Ildaron/ironbci/README.md

# Brain-Computer Interface ironbci (soon will be available in the market)

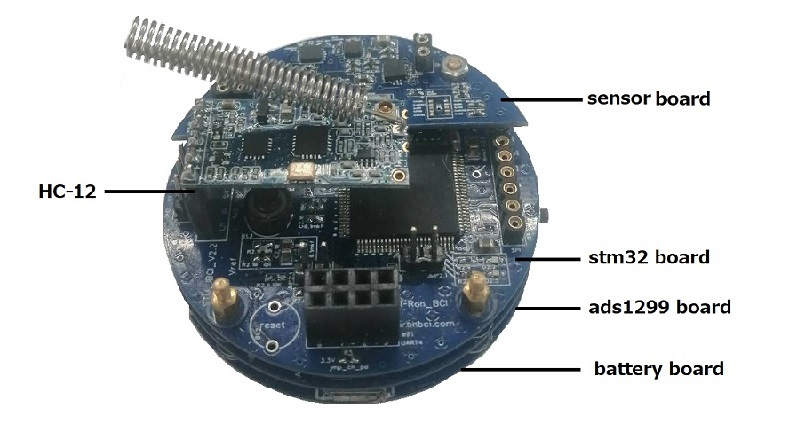
[picture p1: Supplementary files/general_view.jpg]
general view


####  ADS1299 and STM32F407VE 
-  [How it Works](https://github.com/Ildaron/ironbci/blob/master/README.md#1-how-it-works)  
-  [Device pinout](https://github.com/Ildaron/ironbci#2--general-pin-information-about-ads1299-signals)   
-  [Configuration of control registers](https://github.com/Ildaron/ironbci#3-configuration-of-control-registers)     
-  [Description of code ADS_1299.c](https://github.com/Ildaron/ironbci#4-description-of-code-ads_1299c)    
-  [STM32 programming](https://github.com/Ildaron/ironbci#5-stm32-programming)  
-  [Hardware and Signal processing demonstrations](https://github.com/Ildaron/ironbci#6-hardware-and-signal-processing-demonstrations)     
-  [Citation](https://github.com/Ildaron/ironbci/blob/master/README.md#7-citation)   
-  [Contacts](https://github.com/Ildaron/ironbci/blob/master/README.md#8-contacts)     

[GNU license](https://github.com/Ildaron/ironbci/blob/master/license.txt)
#### How it Works  
[Gerbers files](https://github.com/Ildaron/ironbci/tree/master/gerber_files) for PCB boards.  
[Hex file](https://github.com/Ildaron/ironbci/blob/master/ironbci.hex) can be uploaded to STM32F407VE by ST-LINK V2 RST  
   
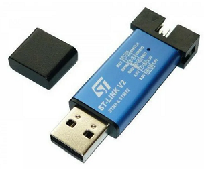
[picture p2: Supplementary files/stl1.bmp]


####  2.  General pin information about ADS1299 signals
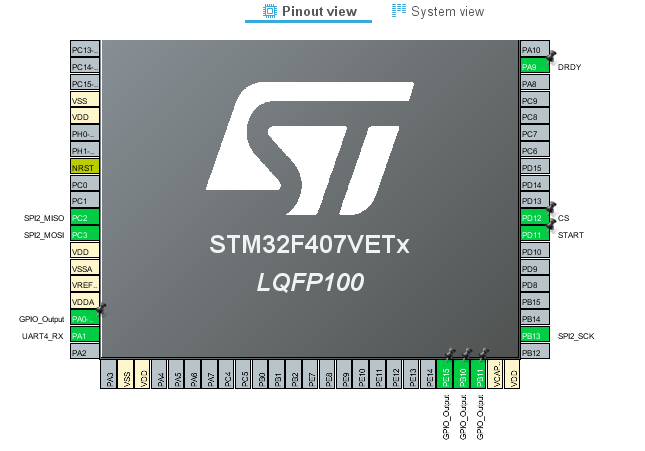
[picture p3: Supplementary files/stm1.bmp]
  
SPI2 for communicate with ADS1299    
UAART4 for send data by HC-12  
2.1.DRDY output -  high when conversion starts    
2.2  Two ways to read data:      
      - RDATA - continuous read command;      
      - SDATA - on request.  
2.3. The amount of input data - 24 * 8 = 192 bits + 24 status bits, a total - 216 bits  

#### 3. Configuration of control registers  

#### 4. Description of code ADS_1299.c  
Data transfer - "s", ends - "p"  
Serial with baud rate - 115200.
 
Hardware demonstrations  
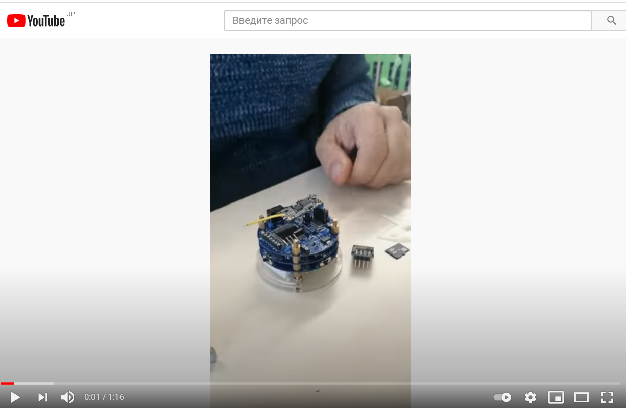
[picture p4: Supplementary files/hardware_ironbci.bmp]
Hardware demonstrations (https://youtu.be/kfbvYXvBCJk)
    
Signal processing by brainflov via timeflux (https://timeflux.io/)    
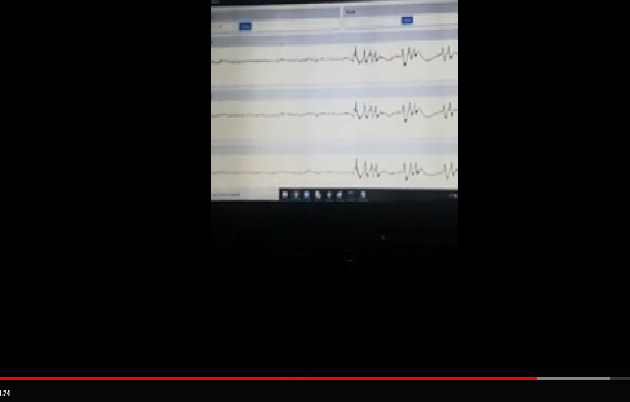
[picture p5: Supplementary files/software.bmp]
Software demonstrations (https://youtu.be/y1O7FNJLeh4)
      

#### 6. Citation  
Rakhmatulin, I., Parfenov, A., Traylor, Z. et al. Low-cost brain computer interface for everyday use. Exp Brain Res (2021). https://doi.org/10.1007/s00221-021-06231-4

#### 7. Contacts   
https://pieeg.com/
