Ildaron/ironbci/SDL/readme.txt

If 120 bytes are currently received, i.e. 40 samples per channel, then now it's the same 120 bytes, but 10 samples per channel. That is, the protocol is 3 bytes, first channel, 3 bytes second channel, 3 bytes third channel, 3 bytes 4th channel and again
