Ildaron/ironbci/Supplementary files/gerber_DIY.bmp

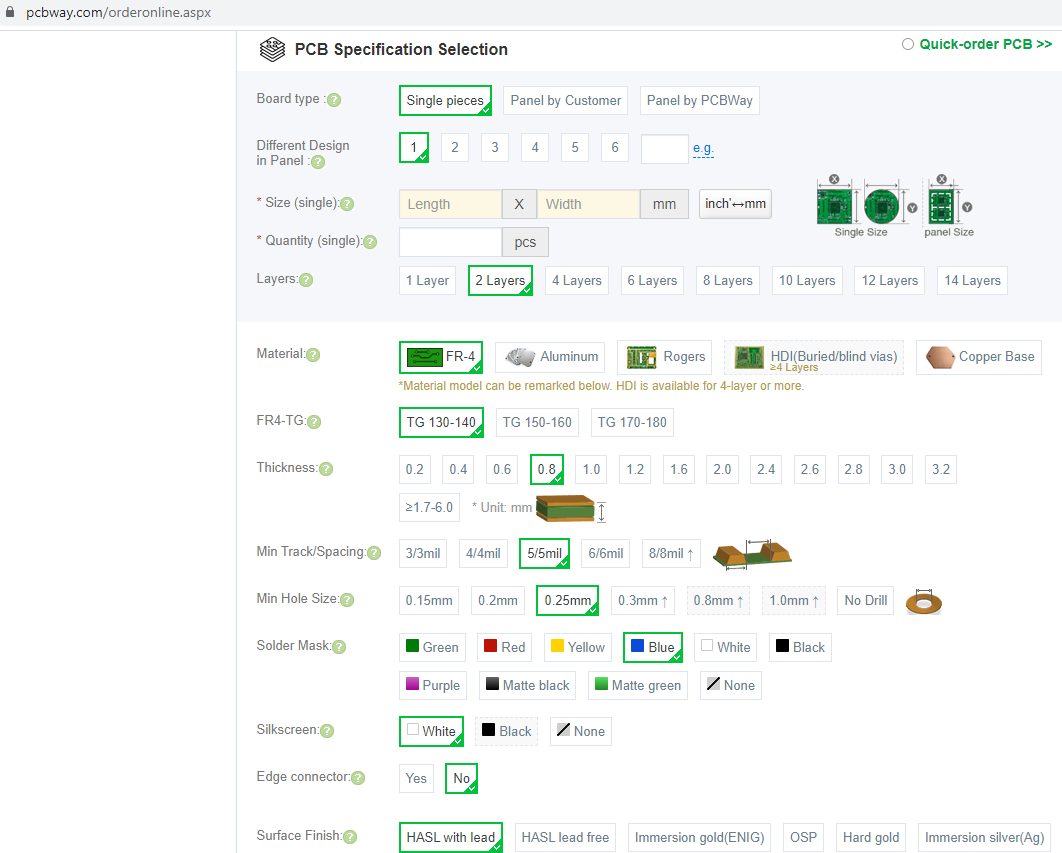
Supplementary files/gerber_DIY.bmp
