Ildaron/ironbci/Supplementary files/pcbway.bmp

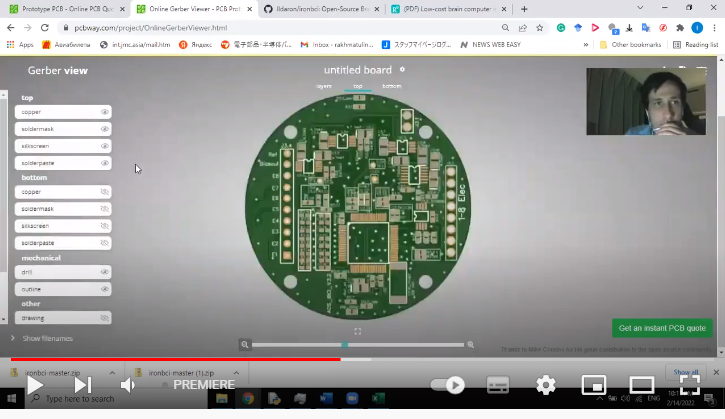
Supplementary files/pcbway.bmp
