Ildaron/ironbci/BOM_files/1.BOM_POWER SUPPLY1.xlsx

 |  |  |  |  |  |  | xxxx xxxx xxxxx xxPCS BOM
3sets unit price |  |  | Your comments | Item # | *Designator | *Qty | Manufacturer | *Mfg Part # | Description / Value | *Package/Footprint | Type | Your Instructions / Notes
$0.105 | $0.315 | Provide 1/16W, no 1/8W, please confirm. | confirm. | 1 | R1.2 | 1 |  |  | RES 110K OHM 1/8W (also acceptable 1/16W) 1% 0402 SMD | 0402 | SMD
$0.105 | $0.315 | Provide 1/16W, no 1/8W, please confirm. | confirm. | 2 | R1.1 | 1 |  |  | RES 15K OHM 1/8W (also acceptable 1/16W) 1% 0402 SMD | 0402 | SMD
$0.105 | $0.315 | Provide 1/16W, no 1/8W, please confirm. | confirm. | 3 | R1.3 | 1 |  |  | RES 1.2K OHM 1/8W (also acceptable 1/16W) 1% 0402 SMD | 0402 | SMD
$0.105 | $0.315 | Provide 1/16W, no 1/8W, please confirm. | confirm. | 4 | R.1.4 | 1 |  |  | RES 0.4 OHM 1/8W (also acceptable 1/16W) 1% 0402 SMD | 0402 | SMD
$0.105 | $0.315 | Provide 1/16W, no 1/8W, please confirm. | confirm. | 5 | R.1.5 | 1 |  |  | RES 1 K OHM 1/8W (also acceptable 1/16W) 1% 0402 SMD | 0402 | SMD
$0.105 | $0.315 | Provide 1/16W, no 1/8W, please confirm. | confirm. | 6 | R.1.6 | 1 |  |  | RES 1 K OHM 1/8W (also acceptable 1/16W) 1% 0402 SMD | 0402 | SMD
$0.105 | $0.315 | Provide 1/16W, no 1/8W, please confirm. | confirm. | 7 | R1.7 | 1 |  |  | RES 1 K OHM 1/8W (also acceptable 1/16W) 1% 0402 SMD | 0402 | SMD
$0.105 | $0.315 | Provide 1/16W, no 1/8W, please confirm. | confirm. | 8 | R1.8 | 1 |  |  | RES 1 K OHM 1/8W (also acceptable 1/16W) 1% 0402 SMD | 0402 | SMD
$0.105 | $0.315 | Provide 1/16W, no 1/8W, please confirm. | confirm. | 9 | R1.9 | 1 |  |  | RES 10 K OHM 1/8W (also acceptable 1/16W) 1% 0402 SMD | 0402 | SMD
$0.525 | $1.575 |  |  | 10 | C1.1 | 1 |  |  | CAP CER 22UF 16V X7R (C0G)1206 | 1206 | SMD
$0.525 | $1.575 |  |  | 11 | C1.2 | 1 |  |  | CAP CER 22UF 16V X7R (C0G)1206 | 1206 | SMD
$0.315 | $0.945 |  |  | 12 | C1.3 | 1 |  |  | CAP CER10UF 16V X7R (C0G)0805 | 805 | SMD
$0.315 | $0.945 |  |  | 13 | C1.4 | 1 |  |  | CAP CER10UF 16V X7R (C0G0805 | 805 | SMD
 | $0.000 | No stock, could you provide the alternative part number? Or can you supply this part to us? | please use - MT3608 | 14 | U1.1 | 1 |  |  | MT3506 |  | SMD
$0.525 | $1.575 |  |  | 15 | U1.2 | 1 |  |  | TC4056A |  | SMD
$0.315 | $0.945 |  |  | 16 | B1.1 | 1 |  |  | MSK-12D19 G2 SPDT 1P2T SMD 3 Pin PCB Panel Horizontal Slide Switch 40JA |  |  | https://www.aliexpress.com/item/4001105071189.html
$0.315 | $0.945 |  |  | 17 | B1.2 | 1 |  |  | MSK-12D19 G2 SPDT 1P2T SMD 3 Pin PCB Panel Horizontal Slide Switch 40JA |  |  | https://www.aliexpress.com/item/4001105071189.html
$0.525 | $1.575 | CDRH104R 22UH |  | 18 | L1.1 | 1 |  |  | 22UH YYT |  | SMD | https://aliexpress.ru/item/4000166903215.html
$0.420 | $1.260 |  |  | 19 | D1.1 | 1 |  |  | SS34 |  | SMD | https://aliexpress.ru/item/1005002002410774.html?s=p&ad_pvid=202108050115474761269999888800003366539_2
$0.210 | $0.630 | Made in China LED 0402 orange |  | 20 | D1.2 | 1 |  |  | LED, ORANGE, lower 20 mA, 3V | 0402 | SMD
$0.210 | $0.630 | Made in China LED 0402 blue |  | 21 | D1.3 | 1 |  |  | LED, BLUE, lower 20 mA, 3V | 0402 | SMD
$0.210 | $0.630 | Made in China LED 0402 green |  | 22 | D1.4 | 1 |  |  | LED, GREEN, lower 20 mA, 3V | 0402 | SMD
$0.263 | $0.788 | Female pin header 1*2pin 2.54mm height:8.5mm Please confirm. | Can you check my order, Order ID: G720488. for elemets - J2.1 was used same of pin | 23 | J.1.1 | 1 |  |  | Round hole pin header 2.54mm pitch row female GOLD single row 2 pins |  |  | https://www.aliexpress.com/item/4001122376295.html?spm=a2g0s.9042311.0.0.27424c4dCdPDpj
$0.525 | $1.575 | According to the link to provide made in China USB | confirm | 24 | J1.2 | 1 |  |  | micro-USB type B |  |  | https://www.aliexpress.com/item/10000001458187.html?s=p&ad_pvid=202108050128122285519604986400008945400_1
$0.210 | $0.630 | XH2.54MM 2P male 180 degrees to the vertical | please see the photo | 25 | J1.3 | 1 |  |  | XH2.54 2 pins bottom side |  |  | https://aliexpress.ru/item/32870387217.html
Total | $19.058
 |  |  |  |  |  |  |  |  | J1.2
According to Description / Value
