Ildaron/ironbci/BOM_files/2.BOM_stm32.xlsx

 |  |  | xxxx xxxx xxxxx xxPCS BOM
Item # | *Designator | *Qty | Manufacturer | *Mfg Part # | Description / Value | *Package/Footprint | Type | Your Instructions / Notes
1 | R2.1 | 1 |  |  | RES 10K OHM 1/8W (also acceptable 1/16W) 1% 0402 SMD | 0402 | SMD
2 | R2.2 | 1 |  |  | RES 10K OHM 1/8W 1% 0402 SMD | 0402 | SMD
3 | R2.3 | 1 |  |  | RES 0K OHM 1/8W 1% 0402 SMD | 0402 | SMD
4 | R2.4 | 1 |  |  | RES 10K OHM 1/8W 1% 0402 SMD | 0402 | SMD
5 | R2.7 | 1 |  |  | RES 10K OHM 1/16W 1% 0402 SMD | 0402 | SMD
6 | R2.12 | 1 |  |  | RES 10K OHM 1/16W 1% 0402 SMD | 0402 | SMD
7 | R2.13 | 1 |  |  | RES 1M OHM 1/16W 1% 0402 SMD | 0402 | SMD
8 | C2.1 | 1 |  |  | CAP CER 10UF 16V X7R (C0G) 0805 | 0805 | SMD
9 | C2.2 | 1 |  |  | CAP CER 0.1UF 16V X7R 0402 | 0402 | SMD
10 | C2.3 | 1 |  |  | CAP CER 10UF 16V X7R 0805 | 0805 | SMD
11 | C2.4 | 1 |  |  | CAP CER 0.1UF 16V X7R 0402 | 0402 | SMD
12 | C2.5 | 1 |  |  | CAP CER 4.7UF 16V X7R (C0G) 0805 | 0805 | SMD
13 | C2.6 | 1 |  |  | CAP CER 10UF 16V X7R (C0G) 0805 | 0805 | SMD
14 | C2.7 | 1 |  |  | CAP CER 10UF 16V X7R (C0G) 0805 | 0805 | SMD
15 | C2.9 | 1 |  |  | CAP CER 0.1UF 16V X7R 0402 | 0402 | SMD
16 | C2.10 | 1 |  |  | CAP CER 10UF 16V X7R (C0G) 0805 | 0805 | SMD
17 | C2.16 | 1 |  |  | CAP CER 0.1UF 16V X7R 0402 | 0402 | SMD
18 | J2.1 | 1 |  |  | Round hole pin header 2.54mm pitch row female GOLD single row 2 pins | N/A | N/A | https://www.aliexpress.com/item/4001122376295.html?spm=a2g0s.9042311.0.0.27424c4dCdPDpj
19 | J2.2 | 1 |  |  | 2.54 40 Pin 1x4 Single Row Male Breakable Pin Header Connector Strip & Jumper Blocks, Black. 4 pins | N/A | N/A | https://www.aliexpress.com/item/32873263301.html?scm_id=1007.34525.229799.0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
20 | J2.3 | 1 |  |  | Round hole pin header 2.54mm pitch row female GOLD single row 7 pins | N/A | N/A | https://www.aliexpress.com/item/4001122376295.html?spm=a2g0s.9042311.0.0.27424c4dCdPDpj
21 | J2.5 | 1 |  |  | 2.54mm Pitch Single Row Female Header Connector Strip Pinheader 5 Pin For Arduino | N/A | N/A | https://www.aliexpress.com/item/1005001418544370.html?scm_id=1007.33416.213724.0&scm-url=1007.33416.213724.0
22 | J2.6 | 1 |  |  | 2.54 40 Pin 1x3 Single Row Male Breakable Pin Header Connector Strip & Jumper Blocks, Black, 3 pins 2.54m | N/A | N/A | https://www.aliexpress.com/item/32873263301.html?scm_id=1007.34525.229799.0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
23 | D2.1 | 1 |  |  | LED, GREEN, lower 20 mA, 3V | 0402 | SMD
24 | D2.2 | 1 |  |  | LED, GREEN, lower 20 mA, 3V | 0402 | SMD
25 | U2.1 | 1 | STMicroelectronics |  | STM32F407VET6 |  | QFP-100/16x16x0.5
26 | U2.1_V3.3 | 1 | AMS1117-3.3V |  |  |  | SMD
