Ildaron/ironbci/electrical_scheme/Board battery.pdf

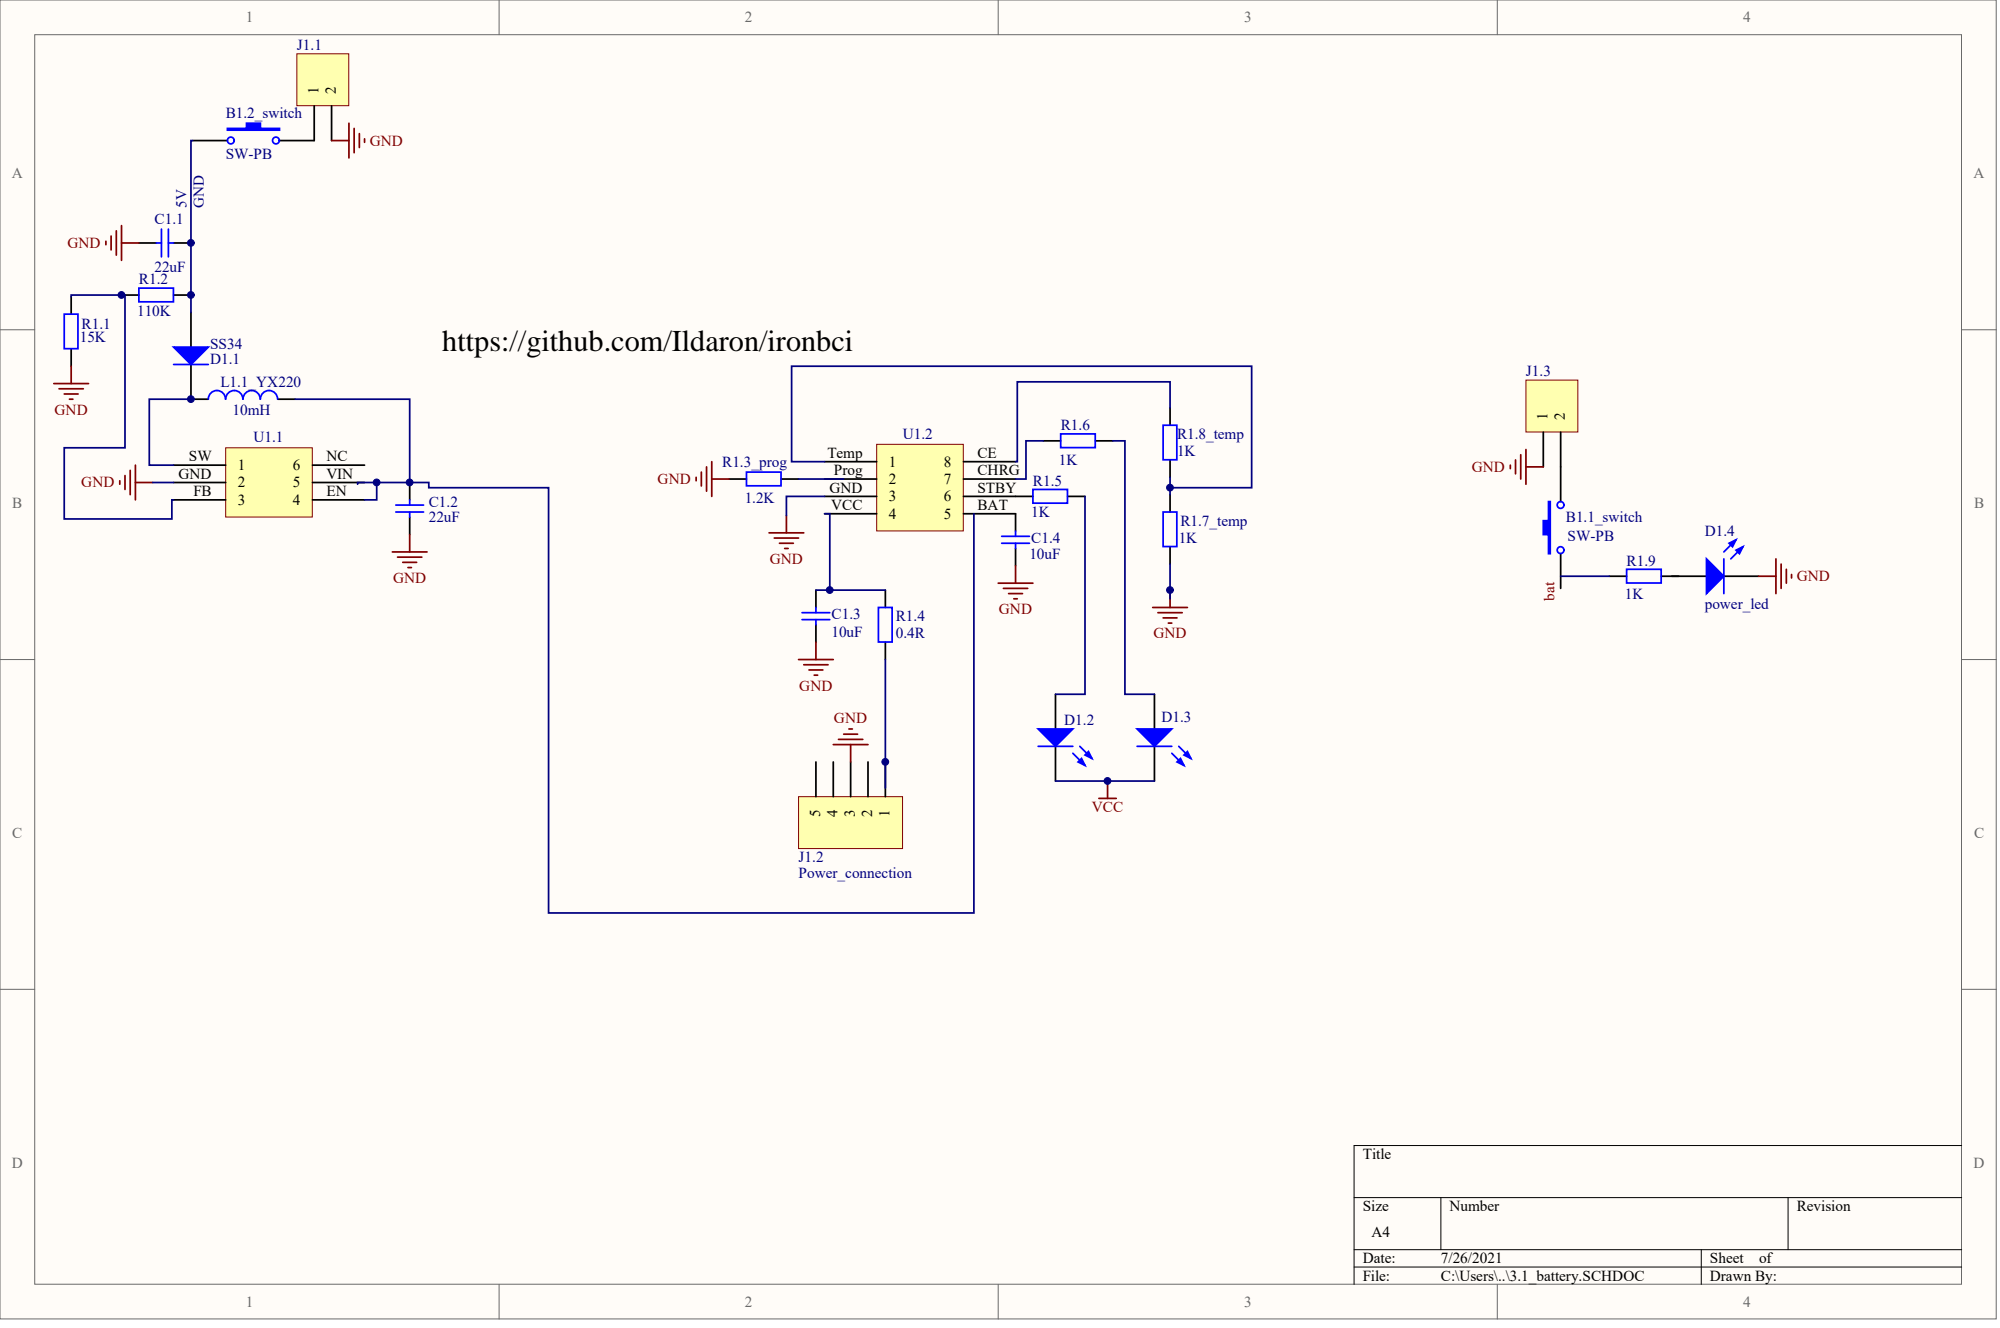
[picture p8: page 1]
Date:; Sheet of File:; C:\Users\..\3.1_battery.SCHDOC; Drawn By; 2 GND; VIN 4; 1 Temp; 2 Prog; 3 GND; 4 VCC; CHRG 6; STBY 5; BAT; J1.2 Power_connection; power_led 1K; P0B1010switch01 P0B1010switch02; P0R1030prog02 P0R1030prog01; P0R1070temp01 P0R1070temp02 P0R1080temp01 P0R1080temp02; P0B1010switch01 P0B1010switch02 P0J10302; P0B1020switch02 P0J10101; P0R1070temp02 P0R1080temp01 P0R1080temp02
