Ildaron/ironbci/electrical_scheme/Board STM32.pdf

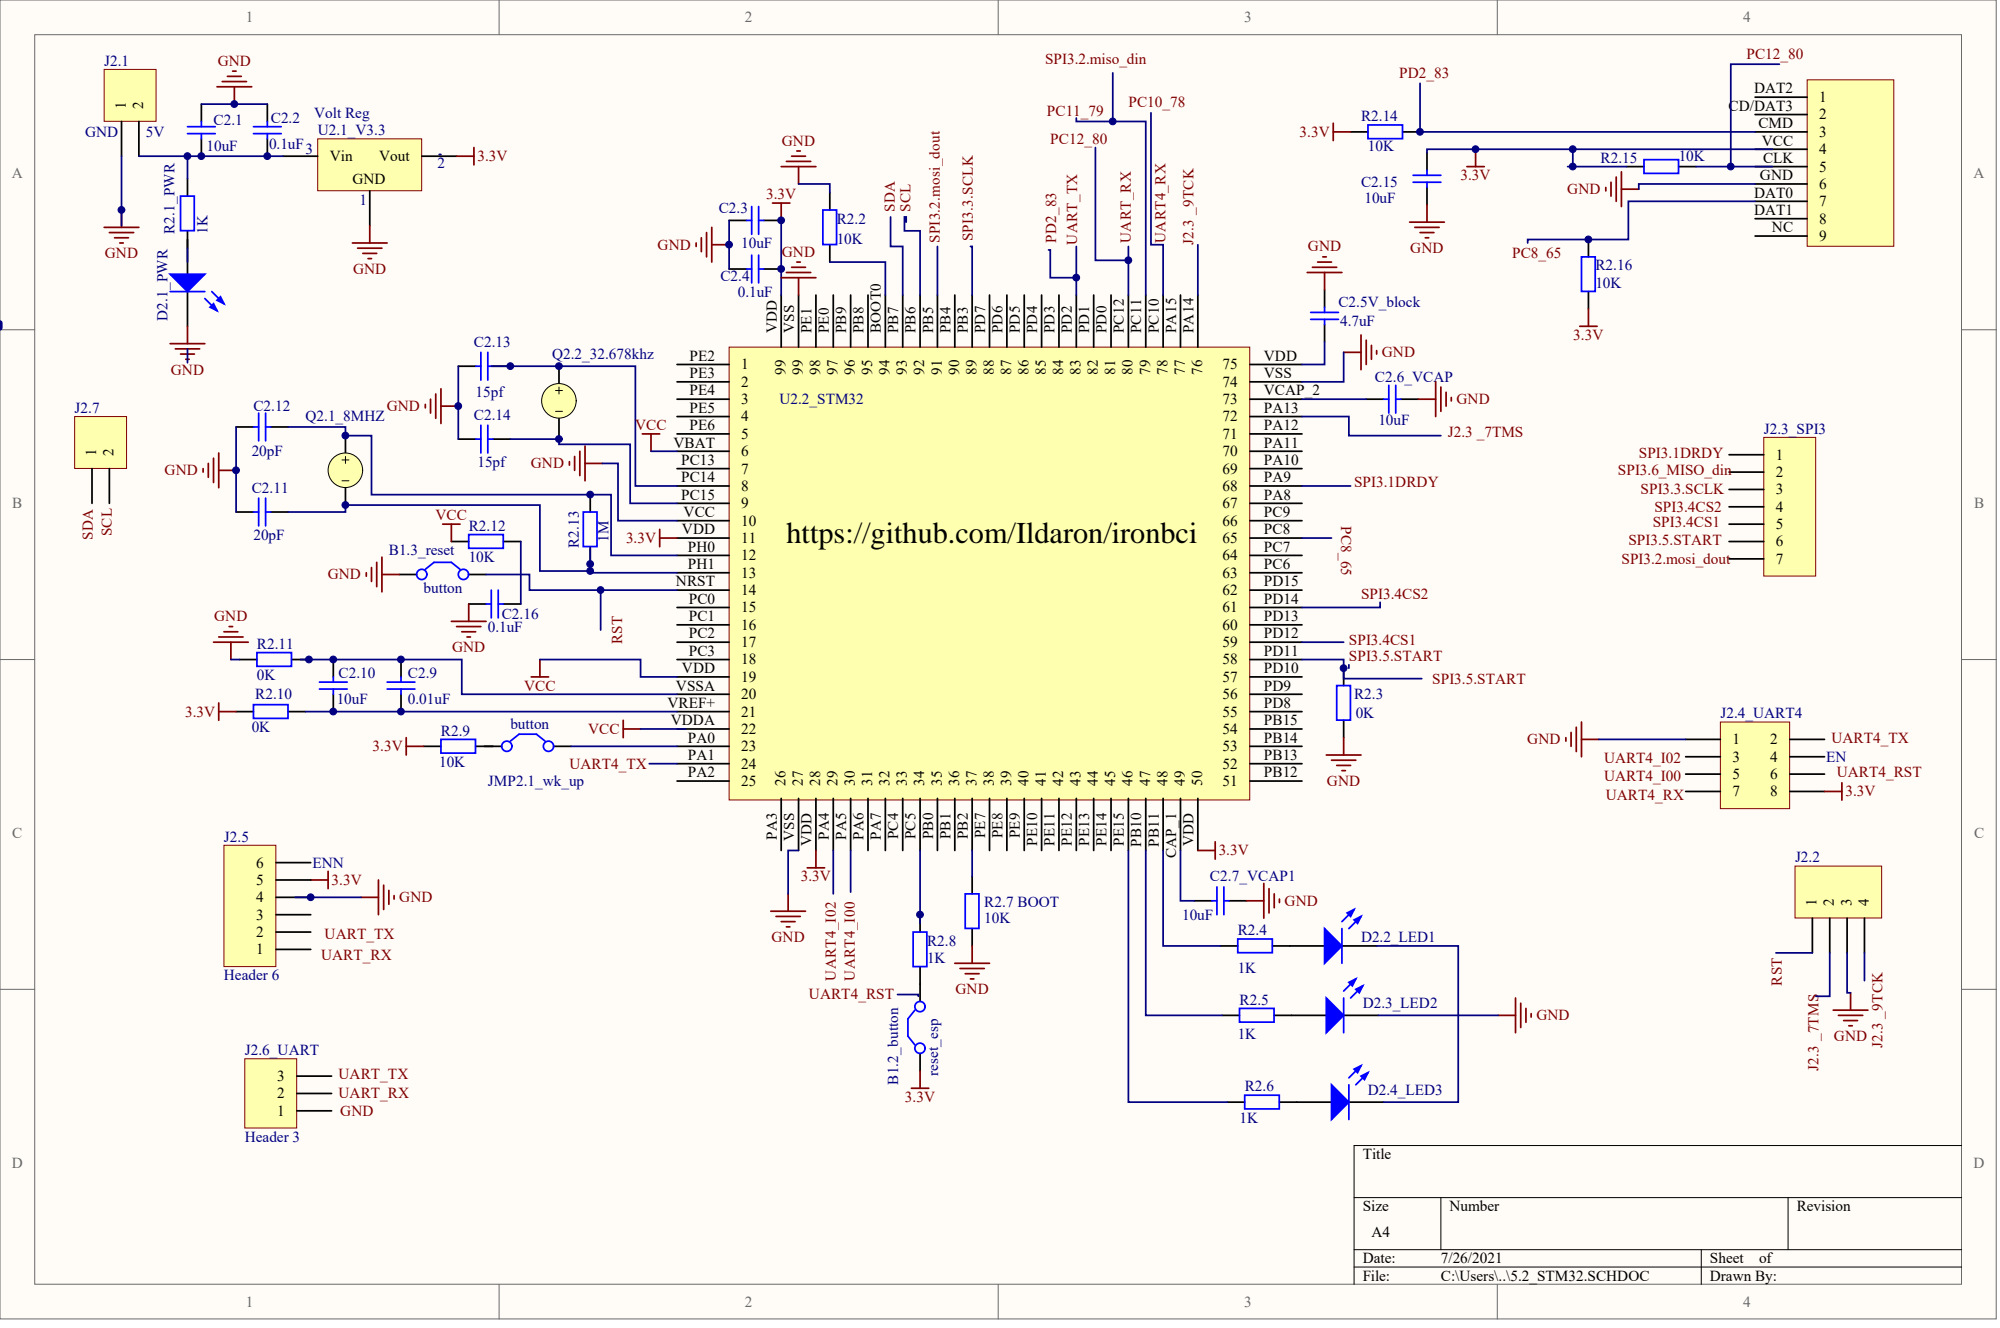
[picture p9: page 1]
Date:; Sheet of File:; C:\Users\..\5.2_STM32.SCHDOC; Drawn By; 6 VBAT; 10 VCC 11 VDD; 14 NRST; 22 VDDA; 27 VSS; 28 VDD; 49 CAP_1; 50 VDD; VCAP_2 74; VSS 75; VDD; 76 PA14 77 PA15 78 PC10 79 PC11 80 PC12 81 PD0 82 PD1 83 PD2 84 PD3 85 PD4 86 PD5 87 PD6 88 PD7 89 PB3 90 PB4 91 PB5 92 PB6 93 PB7 94 BOOT0 95 PB8 96 PB9 97 PE0 98 PE1 99 VSS 99 VDD; Volt Reg; PWR D2.1_PWR; J2.3 _7TMS; R2.7 BOOT; R2.8 reset_esp; 1 DAT2; 2 CD/DAT3; 3 CMD; 4 VCC; 5 CLK; 6 GND; 7 DAT0; 8 DAT1; Header 3 123456; Header 6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

VCC | 19 VDD 20 VSSA

0.01uF | 21 VREF+
