Ildaron/ironbci/electrical_scheme/Sensord board.pdf

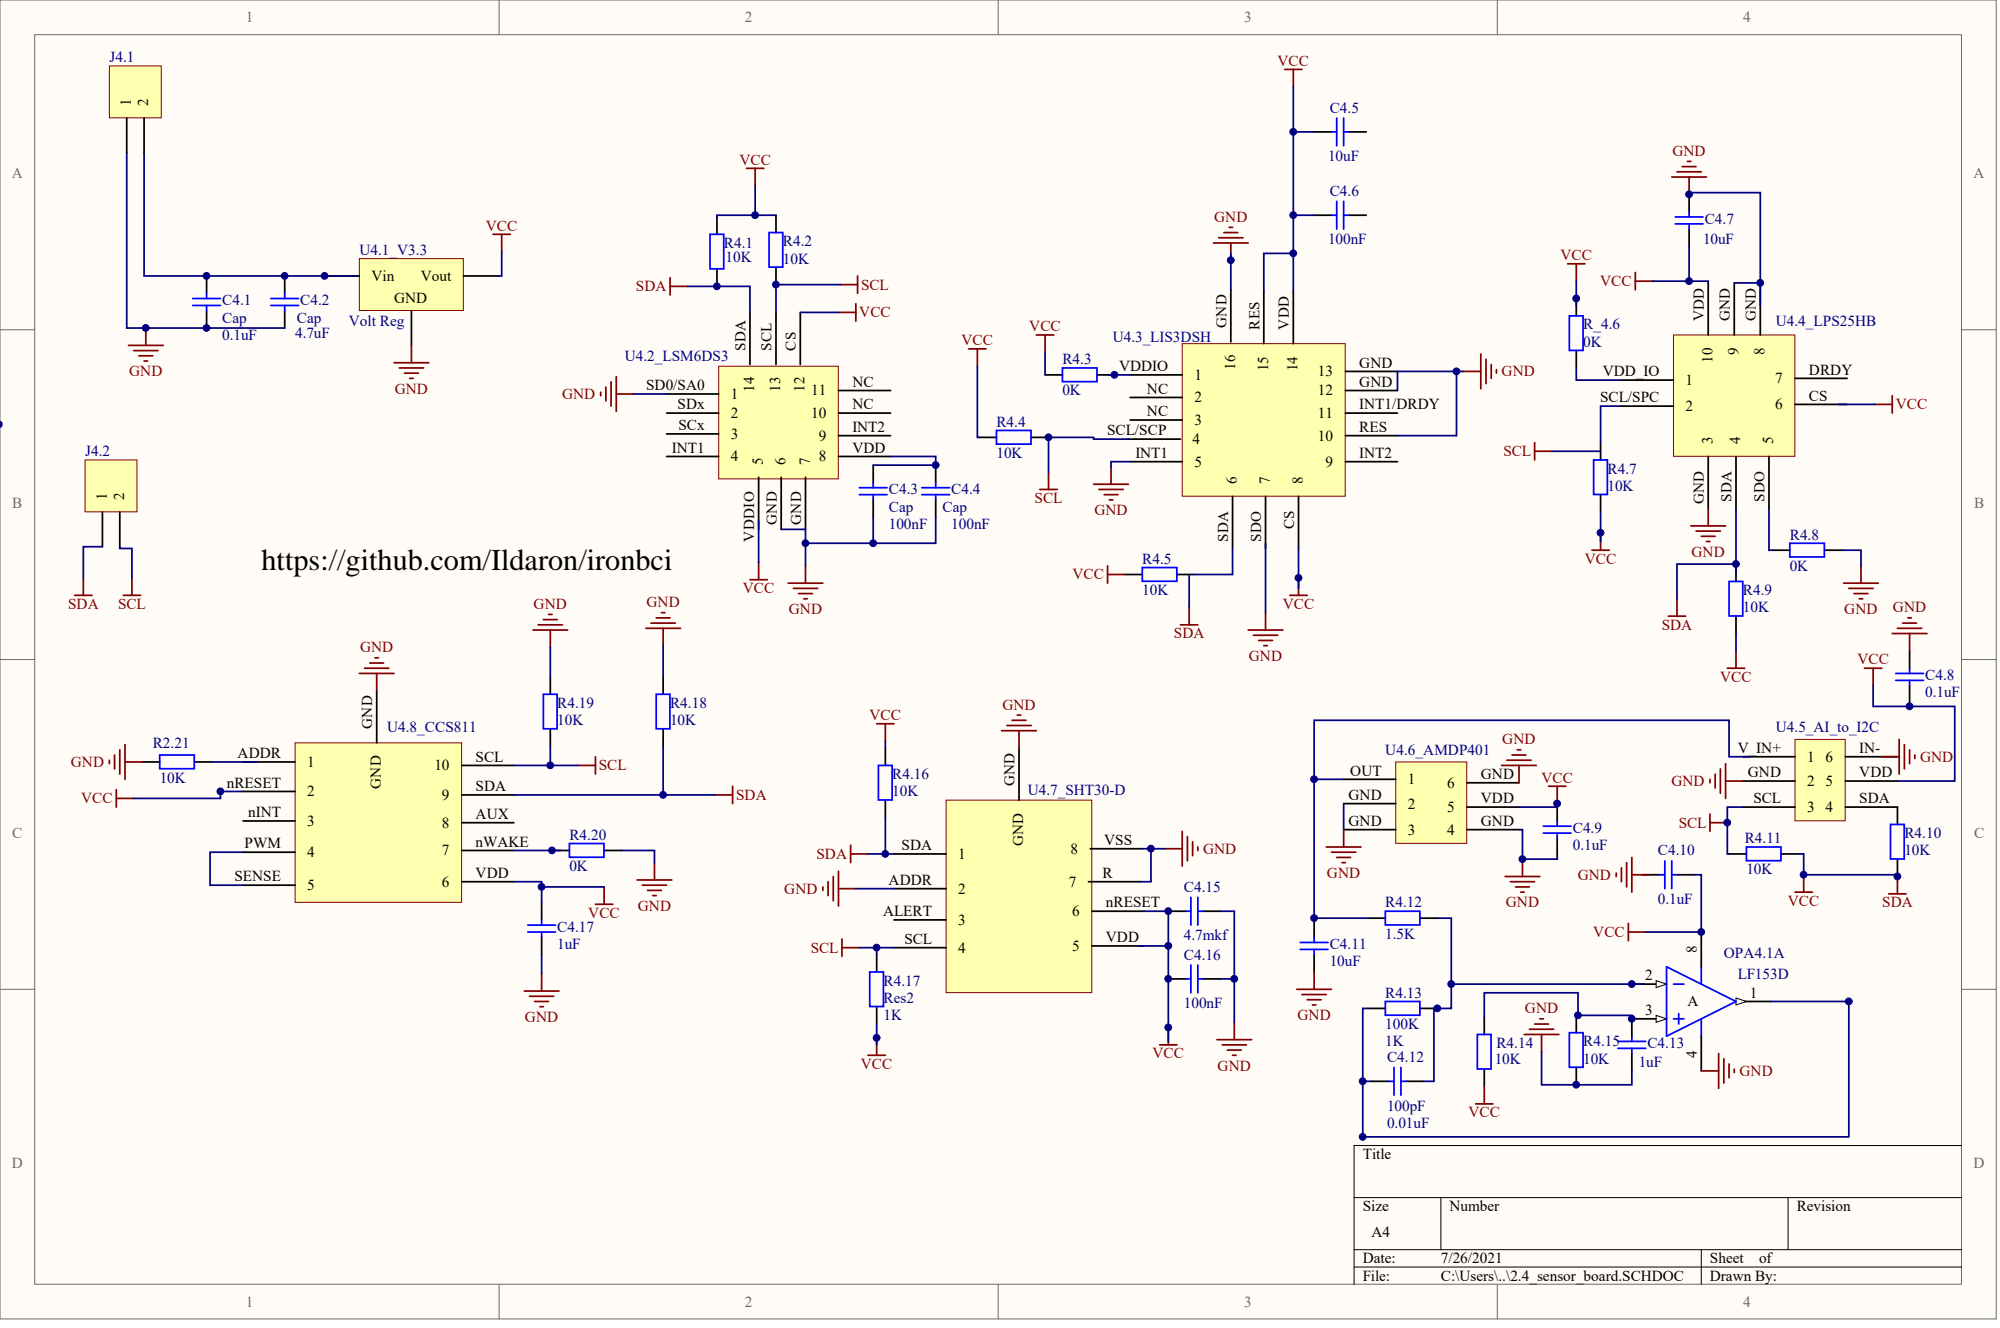
[picture p10: page 1]
Date:; Sheet of File:; C:\Users\..\2.4_sensor_board.SCHDOC; Drawn By; Volt Reg 4.7uF; 2 SDx; 3 SCx; 4 INT1; 5 VDDIO; 6 GND; 7 GND; VDD 9; INT2; 13 SCL; 14 SDA; 4 SCL/SCP; 1 VDDIO; 6 SDA; 7 SDO; GND 13; 15 RES; 16 GND; 1 VDD_IO; 2 SCL/SPC; 3 GND; 4 SDA; 5 SDO; DRDY 6; 8 GND; 9 GND; 10 VDD; 1 ADDR; 2 nRESET; 3 nINT; 4 PWM; 5 SENSE; SCL 9; SDA 8; AUX 7; nWAK; GND GND; 1 SDA; 2 ADDR; 3 ALERT; 4 SCL; VSS 7; nRESET 5; VDD; 1 OUT; GND 5; 2 GND; OPA4.1A LF153D; 3 SCL; 2 GND GND; P0C401302 P0OPA401A03
