Ildaron/ironbci/ads1299.ioc

Mcu.UserName=STM32F407VETx
PA0-WKUP.Signal=GPIO_Output
PA1.Signal=UART4_RX
PA9.GPIO_Label=DRDY
PA9.Signal=GPIO_Output
PB10.Signal=GPIO_Output
PB11.Signal=GPIO_Output
PB13.Signal=SPI2_SCK
PB3.Signal=SPI3_SCK
PB5.Signal=SPI3_MOSI
PC10.Signal=UART4_TX
PC11.Signal=SPI3_MISO
PC12.Signal=UART5_TX
PC2.Signal=SPI2_MISO
PC3.Signal=SPI2_MOSI
PD11.GPIO_Label=START
PD11.Signal=GPIO_Output
PD12.GPIO_Label=CS
PD12.Signal=GPIO_Output
PD2.Signal=UART5_RX
PE15.Signal=GPIO_Output
